T1anyu-zhao/2022Project_Rover/Radar/Data and Graphs/Amplifier_output_integrate_to_rover_2.png

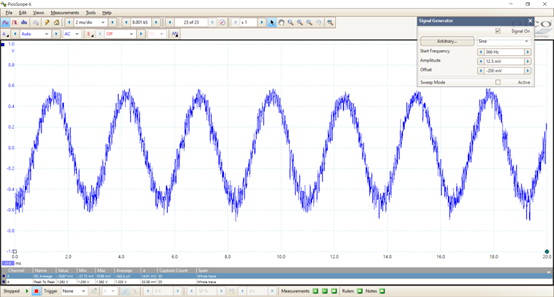
Radar/Data and Graphs/Amplifier_output_integrate_to_rover_2.png
