T1anyu-zhao/2022Project_Rover/README.md

# 2022Project_Rover
for updating and share code
