T1anyu-zhao/2022Project_Rover/Vision/DE10_LITE_D8M_VIP_16/db/ip/sld2d1b536e/alt_sld_fab__report.html

alt_sld_fab

2022.06.26.21:00:17 | Datasheet

Overview

Memory Map

## alt_sld_fab

alt_sld_fab v18.1

Parameters

DESIGN_HASH | cd804ee59db6dc723fb6
NODE_COUNT | 3
MAX_WIDTH | 25
SETTINGS | {fabric sld dir agent mfr_code 110 type_code 128 version 1 instance 0 ir_width 1 psig 9b67919e} {fabric sld dir agent mfr_code 70 type_code 34 version 3 instance 0 ir_width 2 psig 9b67919e} {fabric sld dir agent mfr_code 110 type_code 1 version 0 instance 0 ir_width 2 psig 9b67919e}
CLOCKS | {id {} } {id {} } {id {} }
AGENTS
EP_INFOS | {hpath {Qsys:u0|Qsys_jtag_uart:jtag_uart|alt_jtag_atlantic:Qsys_jtag_uart_alt_jtag_atlantic} } {hpath {Qsys:u0|Qsys_nios2_gen2:nios2_gen2|Qsys_nios2_gen2_cpu:cpu|Qsys_nios2_gen2_cpu_nios2_oci:the_Qsys_nios2_gen2_cpu_nios2_oci|Qsys_nios2_gen2_cpu_debug_slave_wrapper:the_Qsys_nios2_gen2_cpu_debug_slave_wrapper|sld_virtual_jtag_basic:Qsys_nios2_gen2_cpu_debug_slave_phy|sld_virtual_jtag_impl:sld_virtual_jtag_impl_inst} } {hpath {pzdyqx:nabboc} }
MIRROR | 0
TOP_HUB | 1
COMPOSED_SETTINGS | {fabric sld dir agent mfr_code 110 type_code 128 version 1 instance 0 ir_width 1 bridge_agent 0 prefer_host {} } {fabric sld dir agent mfr_code 70 type_code 34 version 3 instance 0 ir_width 2 bridge_agent 0 prefer_host {} } {fabric sld dir agent mfr_code 110 type_code 1 version 0 instance 0 ir_width 2 bridge_agent 0 prefer_host {} }
DEVICE_FAMILY | MAX10FPGA
AUTO_DEVICE | Unknown
AUTO_DEVICE_SPEEDGRADE | Unknown
deviceFamily | UNKNOWN
generateLegacySim | false

Software Assignments
(none)

## alt_sld_fab_presplit

altera_super_splitter v18.1

Parameters

MAX_WIDTH | 25
SEND_WIDTHS | 3 4 4
RECEIVE_WIDTHS | 24 25 25
deviceFamily | UNKNOWN
generateLegacySim | false

Software Assignments
(none)

## alt_sld_fab_splitter

altera_sld_splitter v18.1

alt_sld_fab_presplit | pass | alt_sld_fab_splitter
| nodes
alt_sld_fab_sldfabric | clock_0
| clock_0
| node_0
| node_0
| clock_1
| clock_1
| node_1
| node_1
| clock_2
| clock_2
| node_2
| node_2

Parameters

FRAGMENTS

{{name clock type clock dir end ports { {tck clk in 1 0} } } {name node type conduit dir end ports { {tms tms in 1 1} {tdi tdi in 1 2} {tdo tdo out 1 0} {ena ena in 1 3} {usr1 usr1 in 1 4} {clr clr in 1 5} {clrn clrn in 1 6} {jtag_state_tlr jtag_state_tlr in 1 7} {jtag_state_rti jtag_state_rti in 1 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
EXAMPLE
ADD_INTERFACE_ASGN | 0
deviceFamily | UNKNOWN
generateLegacySim | false

Software Assignments
(none)

## alt_sld_fab_jtagpins

altera_jtag_pins_bridge v18.1

Parameters

deviceFamily | UNKNOWN
generateLegacySim | false

Software Assignments
(none)

## alt_sld_fab_sldfabric

altera_sld_jtag_hub v18.1

alt_sld_fab_jtagpins | clock | alt_sld_fab_sldfabric
| clock
| node
| node
| | | clock_0 | alt_sld_fab_splitter
| | | clock_0
| | | node_0
| | | node_0
| | | clock_1
| | | clock_1
| | | node_1
| | | node_1
| | | clock_2
| | | clock_2
| | | node_2
| | | node_2
| | | ident | alt_sld_fab_ident
| | | ident_0

Parameters

DEVICE_FAMILY | MAX10FPGA
SETTINGS | {mfr_code 110 type_code 128 version 1 instance 0 ir_width 1 bridge_agent 0 prefer_host {} } {mfr_code 70 type_code 34 version 3 instance 0 ir_width 2 bridge_agent 0 prefer_host {} } {mfr_code 110 type_code 1 version 0 instance 0 ir_width 2 bridge_agent 0 prefer_host {} }
COUNT | 3
N_SEL_BITS | 2
N_NODE_IR_BITS | 5
NODE_INFO | 000000000000100001101110000000000001100100010000010001100000000000001100000000000110111000000000
COMPILATION_MODE | 0
BROADCAST_FEATURE | 1
FORCE_IR_CAPTURE_FEATURE | 1
FORCE_PRE_1_4_FEATURE | 0
NEGEDGE_TDO_LATCH | 1
ENABLE_SOFT_CORE_CONTROLLER | 0
TOP_HUB | 1
CONN_INDEX | 0
deviceFamily | UNKNOWN
generateLegacySim | false

Software Assignments
(none)

## alt_sld_fab_ident

altera_connection_identification_hub v18.1

alt_sld_fab_sldfabric | ident | alt_sld_fab_ident
| ident_0

Parameters

DESIGN_HASH | cd804ee59db6dc723fb6
COUNT | 1
SETTINGS | {width 4 latency 0}
deviceFamily | UNKNOWN
generateLegacySim | false

Software Assignments
(none)

generation took 0.00 seconds | rendering took 0.04 seconds
