T1anyu-zhao/2022Project_Rover/Command/rover.png

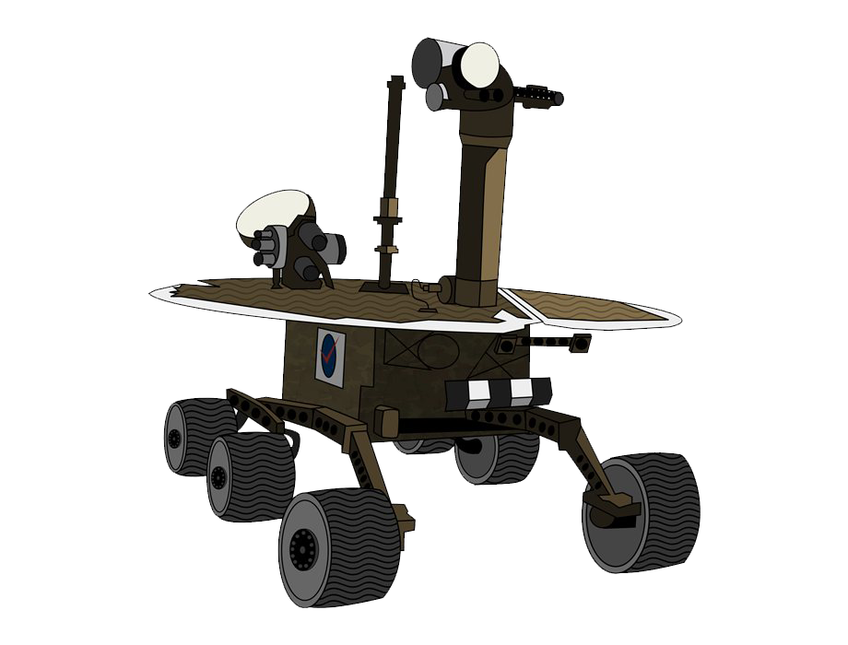
Command/rover.png
