T1anyu-zhao/2022Project_Rover/Energy/Data and Graphs/Combination_Choices.png

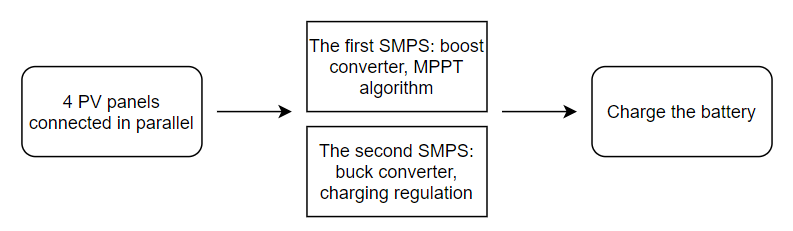
Energy/Data and Graphs/Combination_Choices.png
