T1anyu-zhao/2022Project_Rover/Energy/Data and Graphs/Controller_final_flowchart.png

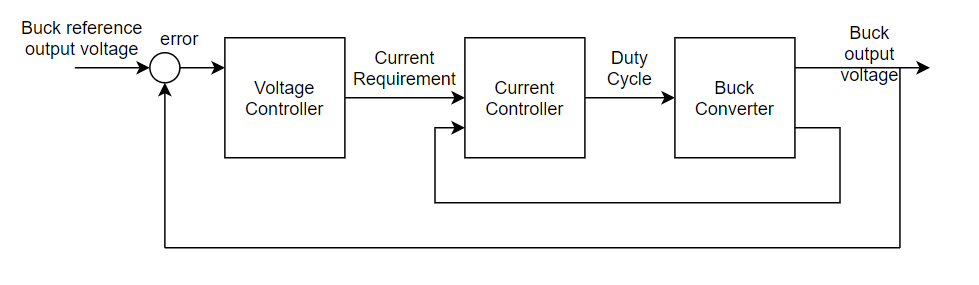
Energy/Data and Graphs/Controller_final_flowchart.png
