T1anyu-zhao/2022Project_Rover/Energy/Data and Graphs/Controller_Flowchart.png

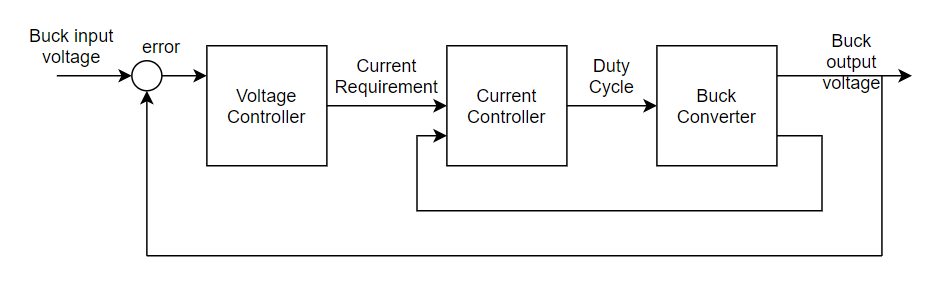
Energy/Data and Graphs/Controller_Flowchart.png
