T1anyu-zhao/2022Project_Rover/Radar/Data and Graphs/Amplifier_LTSpice_simulation.png

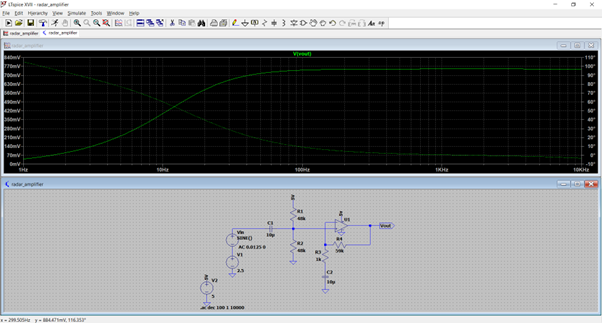
Radar/Data and Graphs/Amplifier_LTSpice_simulation.png
