T1anyu-zhao/2022Project_Rover/Radar/Data and Graphs/Amplifier_output_gain59.png

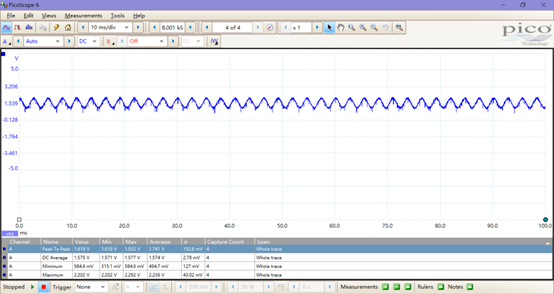
Radar/Data and Graphs/Amplifier_output_gain59.png
