T1anyu-zhao/2022Project_Rover/Radar/Data and Graphs/Bandpass_filter_integrate_to_rover.png

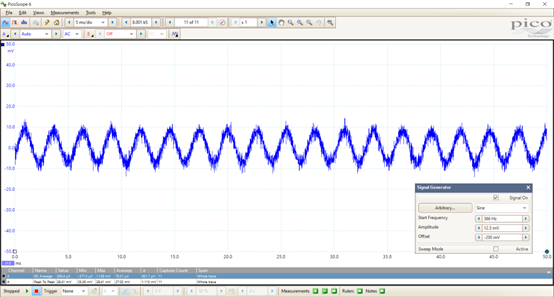
Radar/Data and Graphs/Bandpass_filter_integrate_to_rover.png
