T1anyu-zhao/2022Project_Rover/Radar/Data and Graphs/Bandpass_filter_LTSpice_simulation.png

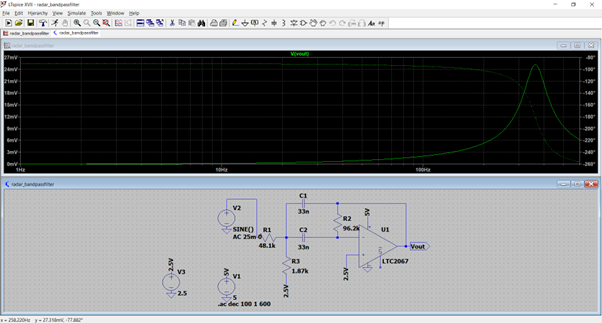
Radar/Data and Graphs/Bandpass_filter_LTSpice_simulation.png
