T1anyu-zhao/2022Project_Rover/Radar/Data and Graphs/Bandpass_filter_output_AC.png

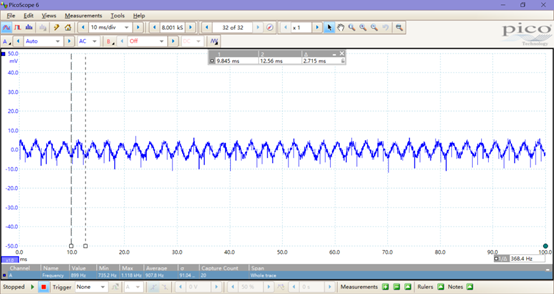
Radar/Data and Graphs/Bandpass_filter_output_AC.png
