T1anyu-zhao/2022Project_Rover/Radar/Data and Graphs/Peak_detector_output.png

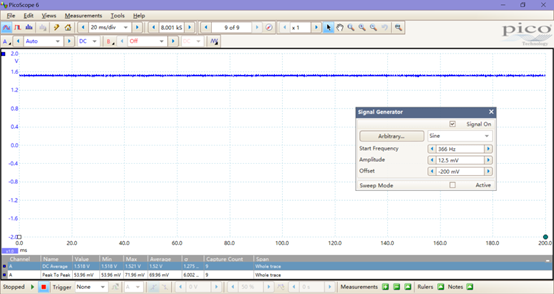
Radar/Data and Graphs/Peak_detector_output.png
