T1anyu-zhao/2022Project_Rover/Radar/envelope_detector_second_3.asc

C1: cap; 100µ
D1: diode
R1: res; 50k
V1: voltage; SINE(1.65 1.25 366); AC 1.25 0
Named nets: 0, output
.tran 0 0.5 0 0.01
