T1anyu-zhao/2022Project_Rover/Radar/radar_amplifier_3_second.asc

C2: cap; 10µ
R3: res; 1k
R4: res; 99k
U1: UniversalOpAmp
V1: voltage; 1.65
V2: voltage; 3.3
Vin: voltage; SINE(); AC 0.0125 0
Named nets: 0, 3.3V, Vout, 5v
.ac dec 100 1 10000
