T1anyu-zhao/2022Project_Rover/Radar/radar_bandpassfilter_3.asc

C1: cap; 33n
C2: cap; 33n
R1: res; 48.1k
R2: res; 96.2k
R3: res; 1.87k
U1: LTC2067
V1: voltage; 3.3
V2: voltage; SINE(0 12.5m 366); AC 12.5m 0
V3: voltage; 1.65
V4: voltage; -200m
Named nets: 0, 3.3V, Vout, 1.65V
.ac dec 100 1 1k
