T1anyu-zhao/2022Project_Rover/Radar/envelope_detector_final.asc

C1: cap; 100µ
D1: diode
R1: res; 50k
V1: voltage; SINE(1.6 1.5 366); AC 1.5 0
Named nets: 0, output
