T1anyu-zhao/2022Project_Rover/Radar/radar_amplifier_final.asc

C1: cap; 10µ
C2: cap; 10µ
R1: res; 48k
R2: res; 48k
R3: res; 1k
R4: res; 59k
U1: UniversalOpAmp
V1: voltage; 2.5
V2: voltage; 5
Vin: voltage; SINE(); AC 0.0125 0
Named nets: 0, 5V, Vout, 5v
.ac dec 100 1 10000
