T1anyu-zhao/2022Project_Rover/Radar/radar_bandpassfilter_final.asc

C1: cap; 33n
C2: cap; 33n
R1: res; 48.1k
R2: res; 96.2k
R3: res; 1.87k
U1: LTC2067
V1: voltage; 5
V2: voltage; SINE(); AC 25m 0
V3: voltage; 2.5
Named nets: 0, 5V, Vout, 2.5V
.ac dec 100 1 600
