T1anyu-zhao/2022Project_Rover/Radar/radar_combined_first_version.asc

C1: cap; 100n
C2: cap; 100n
R1: res; 6366
R2: res; 6366
R3: res; 6366
R4: res; 6366
R7: res; 100
R8: res; 9900
U1: UniversalOpAmp
U2: UniversalOpAmp
V1: voltage; -200m
V2: voltage; 5
Vin: voltage; SINE(); AC 0.025 0
Named nets: 0, 5V, Vout, 5v, Vout1
.ac dec 100 1 10000
