T1anyu-zhao/2022Project_Rover/Radar/Highpass_Filter/radar_highpass.asc

C1: cap; 100n
C2: cap; 100n
R1: res; 6366
R2: res; 6366
R3: res; 5k
R4: res; 5k
U1: UniversalOpAmp
V2: voltage; 5
Vin: voltage; SINE(-0.2); AC 0.025 0
Named nets: 0, 5V, Vout, Vin, 5v
.ac dec 100 1 1000
