T1anyu-zhao/2022Project_Rover/(commit log)

2022-06-01 Add files via upload
    Separate MPPT and Charging Regulation
    First Version code
2022-06-03 Add files via upload
    The first version of the combined overall algorithm for the charging system
2022-06-07 Radar Highpass Filter
2022-06-15 Update and rename Buck_MPPT.ino to Boost_MPPT.ino
2022-06-21 vision basical
    [DE10_LITE_D8M_VIP.smp_dump.txt]
2022-06-22 filter applied
2022-06-24 Update and rename Buck_OL_Second.ino to Buck_OL_Final.ino
2022-06-24 added battery level indicator
2022-06-27 PHP_Success
    Successfully select all the values in the database, but have not implement the algorithm to give the instruction to the driver.
2022-06-27 Optical-Sensor
    Submit the code that could be test in the manual mode.
2022-06-27 Manual_Complete
    Manual Operation Mode is added in the code, but we implement the previous Web-App ,no Manual button used.
2022-06-28 Add files via upload
    3.3V version
